stevenli518/CuBoulder_ECEN4610-20_Capstone/readme.md

# Cu-Boulder-ECEN-Capstone-Project-Team808

## Scalable Electrosurgical Unit for Controlling and Powering the Ligasure Dissection Device
Team Member:

- Sonal Tamrakar (Team Lead/PCB Design Specialist)
- Rustin Chang (Hardware Lead)
- Ali Moran (Product Manual Editor)
- Chengming Li (Software Lead)
- Daniel Chun (Financial Manager/Morale Manager)
- Noah Zhao (Communications Manager)

### Project Info:
An electrosurgical device, or ESU, is a surgical incision device used to incise and remove organic tissue efficiently while controlling bleeding. As it currently stands, ESUs are inaccessible to many parts of the world due to their power generator’s steep cost and large size. Our product is a smaller, less expensive ESU, a complete system with a generator, which runs off of an AC wall connection along with batteries. A portable, relatively cheap generator that connects to pre-existing Ligasure devices reliably provides the electrical signals and control functions required by the ESUs, which along with a clear guided user interface makes this ESU system accessible to medical fields in developing countries.
