stevenli518/CuBoulder_ECEN4610-20_Capstone/Semester 2/Week 1/Volt. Sense Calculations.docx

3.3/288=0.01145833333

(288 V)/(0.01 A)=28800 Ω

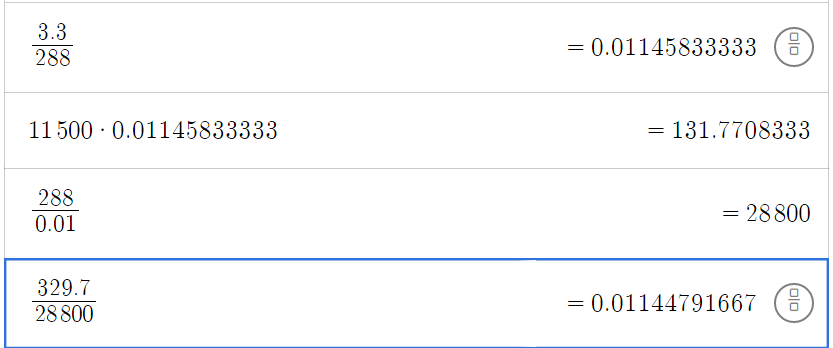
[picture p1: figure]

X_c (reactance)=1/(2πfC)

330=1/(2πfC)=>C_1 (bottom cap->output)=1.08869*10^(-9) F

28470=1/(2πfC)=>C_2 (top cap)=1.26191*10^(-11) F

v_1 =v_(in) (C_2)/(C_1 +C_2)

v_2 =v_(in) (C_1)/(C_1 +C_2)

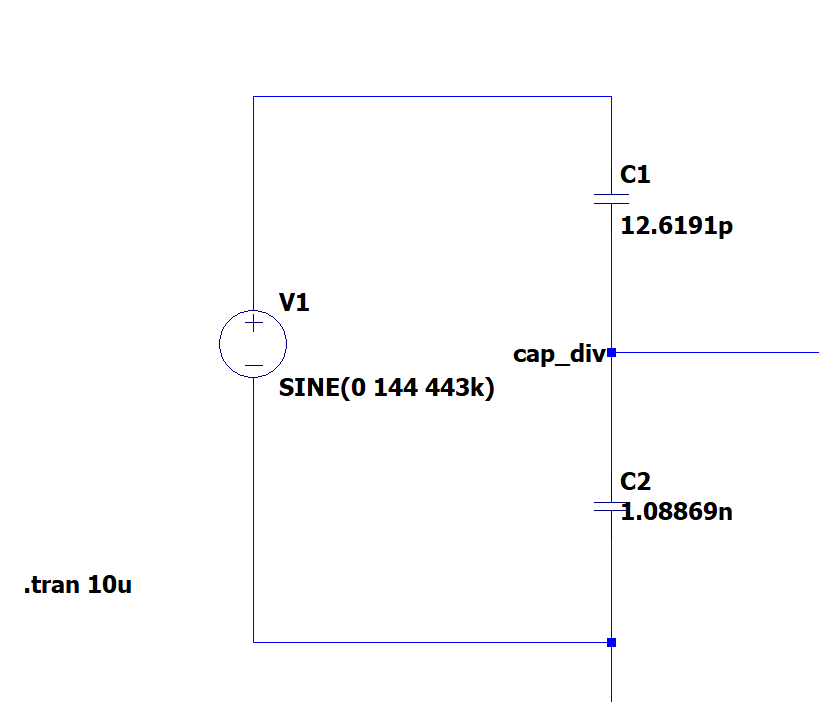
[picture p2: figure]
