stevenli518/CuBoulder_ECEN4610-20_Capstone/Semester 2/Week 10/TA_CHECK_IN_03_23_2023.pptx

## Team 808 Scalable ESU

TA Check-In: 03/23/2023

## Sonal Tamrakar

- What I planned to accomplish in the last 2 weeks
  - Finish Integration Test #3
  - Start working on getting the box dimensions and box ordered
  - Mount heatsinks and insert the system on a mount provided by Medtronic
- What I actually accomplished in the last 2 weeks
  - Finished Integration Test #3
  - Resoldered processors on the shorted controller board (3.3VDig to GND shorted)
  - Installed new FETs (100V rated) + heat sink
- What I expect to accomplish in the next 2 weeks
  - Get the box ordered with the appropriate dimensions
  - Finish Product Manual and Acceptance next plan
  - Create BOM for all schematic components.

## Rustin Chang

- What I planned to accomplish in the last 2 weeks
  - Integration test #3
  - Wind Isolation transformer
  - Figuring out layout of system box
- What I actually accomplished in the last 2 weeks
  - Finished integration test #3
  - Winded Isolation transformer
  - Figured out how to layout the systeem box
- What I expect to accomplish in the next 2 weeks
  - Acceptance Test Demo
  - Having box ordered
  - Poster preparation

## Ali Moran

- What I planned to accomplish in the last 2 weeks
  - GUI development
  - Product manual update
  - Implement timing loop
- What I actually accomplished in the last 2 weeks
  - GUI development
  - Prouduct manual update
  - Timing loop
- What I expect to accomplish in the next 2 weeks
  - box stuff
  - finalize gui
  - further testing

## Steven

- What I planned to accomplish in the last 2 weeks
  - Verified the RMS calculations and results
- What I actually accomplished in the last 2 weeks
  - Verified the correctness of of RMS calculations when it’s open circuit
- What I expect to accomplish in the next 2 weeks
  - Find the issue causing incorrect RMS results when it’s connected to the load
  - Finish product manual and acceptance plan

## Noah Zhao

- What I planned to accomplish in the last 2 weeks
  - Final integration test
  - Begin to design enclosure
- What I actually accomplished in the last 2 weeks
  - Final integration test
  - Begin to design enclosure
- What I expect to accomplish in the next 2 weeks
  - Product manual update
  - Acceptance Testing

## Daniel Chun

- What I planned to accomplish in the last 2 weeks
  - RF Tank prototyping
- What I actually accomplished in the last 2 weeks
  - Purchased all components
  - Finished functional RF Tank
- What I expect to accomplish in the next 2 weeks
  - Finish preparations for sensor integration test
  - Continue working with the transfer function of our LCC tank
