stevenli518/CuBoulder_ECEN4610-20_Capstone/Semester 2/Week 12/TA_CHECK_IN_04_06_2023.pptx

## Team 808 Scalable ESU

TA Check-In: 03/23/2023

## Sonal Tamrakar

- What I planned to accomplish in the last 2 weeks
  - Debug the noise measured in the voltage and current sensor opamp
  - Write up a robust acceptance test plan
- What I actually accomplished in the last 2 weeks
  - Added a ferrite bead along with the twisted pair setup connecting back to the ADCs
  - Replaced standard probes with low voltage differential probes to accurately measure voltage + current sensor plots
  - Measured our system with different loads provided by Medtronic (50, 100, 500, 1k, 1.5k)
- What I expect to accomplish in the next 2 weeks
  - Finish the box enclosure for the acceptance test demo
  - Get started on EXPO poster
  - Finalize product enclosure

## Rustin Chang

- What I planned to accomplish in the last 2 weeks
  - Hunt the noise that was appearing with the ADC
  - Wind Isolation transformer
  - product manual update
- What I actually accomplished in the last 2 weeks
  - Fixed the noise with the ADC
  - Winded Isolation transformer
  - Finished product manual update
- What I expect to accomplish in the next 2 weeks
  - Acceptance Test Demo
  - Having box ordered
  - Poster preparation

## Ali Moran

- What I planned to accomplish in the last 2 weeks
  - GUI development
  - get testing board
- What I actually accomplished in the last 2 weeks
  - GUI development
  - product manual update
  - testing board aquired
- What I expect to accomplish in the next 2 weeks
  - poster
  - final preparations for expo
  - understand the magnetics better

## Steven

- What I planned to accomplish in the last 2 weeks
  - Find the issue causing incorrect RMS results when it’s connected to the load
  - Finish product manual and acceptance plan
- What I actually accomplished in the last 2 weeks
  - Find the issue causing incorrect RMS results when it’s connected to the load
  - Finish product manual and acceptance plan
- What I expect to accomplish in the next 2 weeks
  - Invert the collected voltage samples due to the inverting circuit
  - Scale down the current samples because of the sensor resistor
  - Help with the poster

## Noah Zhao

- What I planned to accomplish in the last 2 weeks
  - Spring break
  - Acceptance test plan
  - Product manual update
- What I actually accomplished in the last 2 weeks
  - Spring break
  - Acceptance test plan
  - Product manual update
- What I expect to accomplish in the next 2 weeks
  - Complete system enclosure
  - Acceptance Testing

## Daniel Chun

- What I planned to accomplish in the last 2 weeks
  - Finish product manual design section
- What I actually accomplished in the last 2 weeks
  - Completed all design documentation for product manual
  - Began finalizing power budget
- What I expect to accomplish in the next 2 weeks
  - Finalize all hardware quirks
  - Fabricate the box for our system
  - Begin preparations for expo
