stevenli518/CuBoulder_ECEN4610-20_Capstone/Semester 2/Week 13/TA_CHECK_IN_04_20_2023.pptx

## Team 808 Scalable ESU

TA Check-In: 04/20/2023

## Sonal Tamrakar

- What I planned to accomplish in the last 2 weeks
  - Finish Acceptance Plan
  - Start with poster
- What I actually accomplished in the last 2 weeks
  - FInish Poster
  - Box setup completed
  - Measured our system with bacon/saline gauze
- What I expect to accomplish in the next 2 weeks
  - Get ready for EXPO

## Rustin Chang

- What I planned to accomplish in the last 2 weeks
  - Put some finishing touches on the project (set up in the box and scope probe placements)
  - Work on Expo poster
- What I actually accomplished in the last 2 weeks
  - Finished up the project
  - Finished the expo poster
- What I expect to accomplish in the next 2 weeks
  - Buying more stuff to fry with the bizact
  - Figure out table set up
  - EXPO!!!!!!!

## Ali Moran

- What I planned to accomplish in the last 2 weeks
  - fix float conversion error
  - fix graphing - either horrid and innacurate or freezes the gui
  - homogenize data input from the board
- What I actually accomplished in the last 2 weeks
  - float conversion fixed
  - graph freezing fixed but now not accepting data
  - data input is now clean
- What I expect to accomplish in the next 2 weeks
  - expo
  - pracitce elevator pitch more
  - finalize gui in the next few days - add extensive comments for next people

## Steven

- What I planned to accomplish in the last 2 weeks
  - Invert the voltage samples due to the inverting circuit
  - Scale down the current samples because of the sensor resistor
  - Help with the poster
- What I actually accomplished in the last 2 weeks
  - Invert the voltage samples due to the inverting circuit
  - Scale down the current samples because of the sensor resistor
  - Help with the poster
- What I expect to accomplish in the next 2 weeks
  - Practice the elevator pitch
  - EXPO

## Noah Zhao

- What I planned to accomplish in the last 2 weeks
  - Complete enclosure
  - Acceptance testing
  - Poster
- What I actually accomplished in the last 2 weeks
  - Complete enclosure
  - Acceptance testing
  - Poster
- What I expect to accomplish in the next 2 weeks
  - Expo preparation
  - Learn all system modules in depth
  - Last product manual update

## Daniel Chun

- What I planned to accomplish in the last 2 weeks
  - Finish final touches on hardware
- What I actually accomplished in the last 2 weeks
  - Finished our project for expo
  - Began finalizing preparations for expo
- What I expect to accomplish in the next 2 weeks
  - Continue preparations for expo
  - Finish product manual
