stevenli518/CuBoulder_ECEN4610-20_Capstone/Semester 2/Week 2/TA_Check-in_1_26_2023.pptx

## Team 808 Scalable ESU

TA Check-In 6: 1/26/2023

## Sonal Tamrakar

- What I planned to accomplish in the last 2 weeks
  - Finalize 2nd PCB (final)
  - Test controller board using power supply.
  - Finalize RF Tank + Voltage Sensor calculations
- What I actually accomplished in the last 2 weeks
  - 2nd PCB (final) almost finished
  - Finished testing controller board using power supply instead of soul bay.
  - Design custom footprints for inductors/caps/transformer
- What I expect to accomplish in the next 2 weeks
  - Finish CDR slides
  - Appt with Medtronic advisor regarding CDR
  - Visit Power Lab

## Rustin Chang

- What I planned to accomplish in the last 2 weeks
  - Finish PCB design
  - Simulate RF tank on LTspice making sure the design is concrete before being placed on the board
  - Implement the inverting OP amp topology
- What I actually accomplished in the last 2 weeks
  - Finished the RF tank design
  - Simulated the RF tank successfully
  - Successfully finished the inverting OP amp topology
- What I expect to accomplish in the next 2 weeks
  - Start working on the integrated design test
  - look into winding transformers and inductors
  - Complete some matlab simulations

## Ali Moran

- What I planned to accomplish in the last 2 weeks
  - GUI development
  - Figure out alternatives for sensors
- What I actually accomplished in the last 2 weeks
  - Started GUI
  - Figured out alternatives but were not using
- What I expect to accomplish in the next 2 weeks
  - Integrate serial/excel into GUI
  - Gain a better understanding of graphing in excel
  - Have a working GUI to test custom boards through

## Steven

- What I planned to accomplish in the last 2 weeks
  - Merge CLA and ADC into the project I am working on
  - Setup the RMS value calculation in the CLA’s tasks
  - Do some experiments to prove the RMS value is correct with 8 samples/ cycle
- What I actually accomplished in the last 2 weeks
  - CLA and ADC is merged into the project(but it not working)
  - RMS value calculation done
  - RMS value close to what oscilloscope gives
- What I expect to accomplish in the next 2 weeks
  - Fix the problem about CLA and ADC
  - Prove the correctness of RMS values

## Noah Zhao

- What I planned to accomplish in the last 2 weeks
  - Redesign of voltage/current sensors
  - Answer some questions from previous semester
- What I actually accomplished in the last 2 weeks
  - Help redo sensor circuits
  - Got some questions answered from previous semester
- What I expect to accomplish in the next 2 weeks
  - MATLAB sim for point by point RMS calculation
  - Answer questions from last check in with Bogatin
  - CDR

## Daniel Chun

- What I planned to accomplish in the last 2 weeks
  - Voltage Sensor final design
  - Current Sensor final design
  - LTspice Simulations
- What I actually accomplished in the last 2 weeks
  - Voltage Sensor final design
  - Successful LTspice Simulations
- What I expect to accomplish in the next 2 weeks
  - Finalize exact values for voltage and current sensors
  - Begin integration testing phase of project
  - Prepare for the CDR
