stevenli518/CuBoulder_ECEN4610-20_Capstone/Semester 2/Week 2/Volt. Sense FINAL.docx

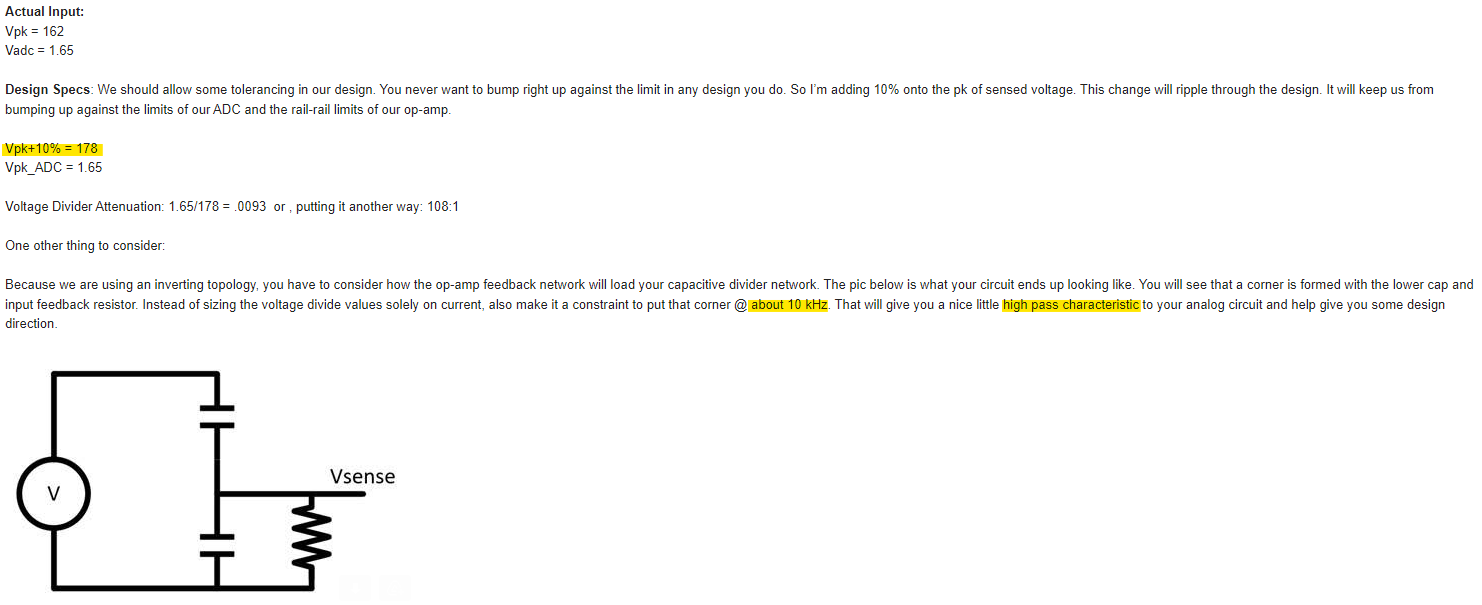
[picture p3: figure]

Parameters

V_(peak) =162V±10%

V_(peak) +Attentuation≈178V

ADC Range: 0V to 3.3V

V_(peak-to-peak) =356V

Calculation of HPF @10kHz

Using 10k Ohm for input feedback resistor

https://www.electronics-tutorials.ws/filter/filter_3.html

10kHz =1/(2π*10k*C_2)=> C_2 =1.59154943*10^(-9) =1.592nF

Solving for C_1

3.3/356=0.009269662921

v_2 =v_(in) (C_1)/(C_1 +C_2) =>3.3=(356)(C_1)/(C_1 + 1.59*10^(-9)) =>C_1 =1.48954*10^(-11) =14.9pF

Calculation of LPF @2.5MHz

R = 10k Ohms

https://www.electronics-tutorials.ws/filter/filter_2.html

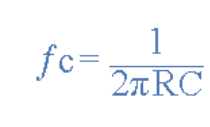
[picture p4: figure]

2.5Meg =1/(2π*10k*C)=>C=6.3662*10^(-12)
