stevenli518/CuBoulder_ECEN4610-20_Capstone/Semester 2/Week 3/Weekly Meeting 1.31.docx

Magnetics:

- Try a few different gauge wires (maybe 26 gauge)
- Experiment with winding first
- https://www.mag-inc.com/Design/Design-Guides/Inductor-Design-with-Magnetics-Ferrite-Cores

CDR:

- Confidence in the project is most important
- Can use current RF tank values but those don’t have to be final. Just need to mention our path
