stevenli518/CuBoulder_ECEN4610-20_Capstone/Semester 2/Week 4 - CDR/CDR notes.docx

RF tank:

- Only have odd harmonics in fourier domain
- Have to put resonance somewhere so put it on 2nd harmonic where there shouldn’t be any energy

Sensing circuits:

- Talk about input/output. Could place in block diagram
- Possibly could run sim. Show bode plot, gain, show it matches calculations
- Corner, gain, bandwidth
- Cap divider to block DC offset caused by asymmetry from AC switching, minimal amount of current flowing into sense node. No DC power loss. Medtronic legacy design decision. Could use resistor. Theoretically no power loss in cap divider

General:

- List design process of any/all sub module
- Show both PCBs instead of eval board in software slides (slide 28)
- Show we are ready for integration testing
- Show transitions of boards and our process/journey
- Describe module functions qualitatively rather than numerically

Overlap of phase gives amplitude control, can leave 48V constant then use phase to control output of square wave
