stevenli518/CuBoulder_ECEN4610-20_Capstone/Semester 2/Week 4 - CDR/Notes_2.8.docx

Primary side of step-up:

- 96V peak-to-peak from h-bridge
- 48V peak

Secondary side of the step-up

- 48V*3 = 144V Peak
- 288V peak-to-peak
- 101.8233765V RMS
