stevenli518/CuBoulder_ECEN4610-20_Capstone/Semester 2/Week 5/RF Tank Capacitors.docx

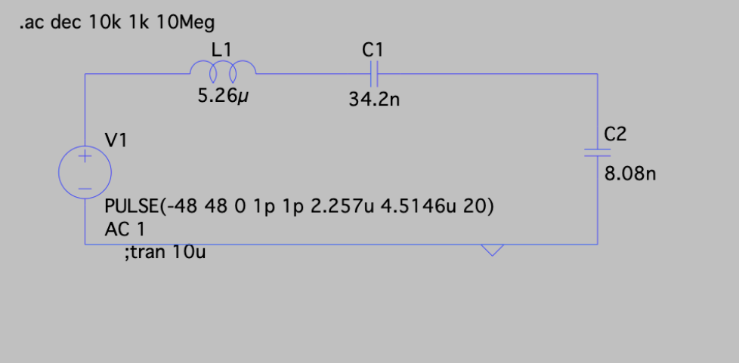
[picture p9: figure]

- C1 has 4 parallel footprints
- C2 has 2 parallel footprints

Current calculations:

- I_(sc) RMS=5A
- d=0.25
- n_(ratio) =2.5

Accounting for 10% variable swing

I_(sc) RMS=5.5A

I_(sc) RMS (Primary) = 5.5*n=> 5.5*2.5=13.75A

Accounter for 25% Duty cycle

I RMS (Primary) 13.75A*0.25=3.4375A

Calculations for C1:

- C_1 (1)=9100pF
- C_1 (2)=9100pF
- C_1 (3)=9100pF
- C_1 (4)=6800pF

https://www.electronics-tutorials.ws/filter/filter_1.html

X_1 (1)=X_1 (2)=X_1 (3)=1/(2π*430000*9100*10^(-12))=40.67338183Ω

X_1 (4)=1/(2π*430000*6800*10^(-12))=54.43055509Ω

https://www.electronics-tutorials.ws/dccircuits/current-divider.html

By current division:

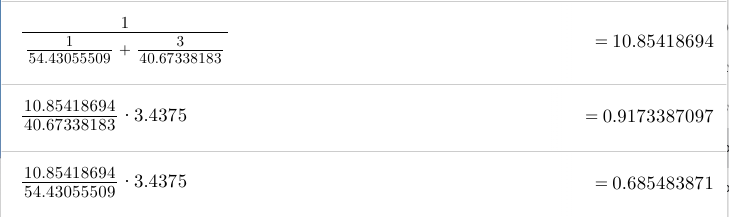
[picture p10: figure]

- 0.9173A through 9100pF capacitors
- 0.6855A through 6800pF capacitors

Calculations for C2:

- C_2 (1)=3900pF
- C_2 (2)=4300pF

(The choice behind the values is to make sure one capacitor isn’t handling a disproportionately large amount of current)

X_2 (1)=1/(2π*430000*3900*10^(-12))=94.9045576Ω

X_2 (2)=1/(2π*430000*4300*10^(-12))=86.07622666Ω

Doing current division

- 1.634908537A through 3900pF
- 1.802591463A through 4300pF
