stevenli518/CuBoulder_ECEN4610-20_Capstone/Semester 2/Week 5/Weekly Meeting 2.14.docx

Transformer:

- Saturation equation

∫_0^(T/2) V_(pk) sin(2πft)dt=(V_(pk))/(πf)

(V_(pk))/(πf)=λ_1 (Volt-seconds)

(V_(pk))/(πf)<n*2ΔB*A_c

Peak Flux Density

B = 200 mT

162 mm^2 = 0.000162 m^2

61V Peak

178V Peak

Inductor:

- Inductance equation

(μ_0 A_C n^2)/(2l_g)

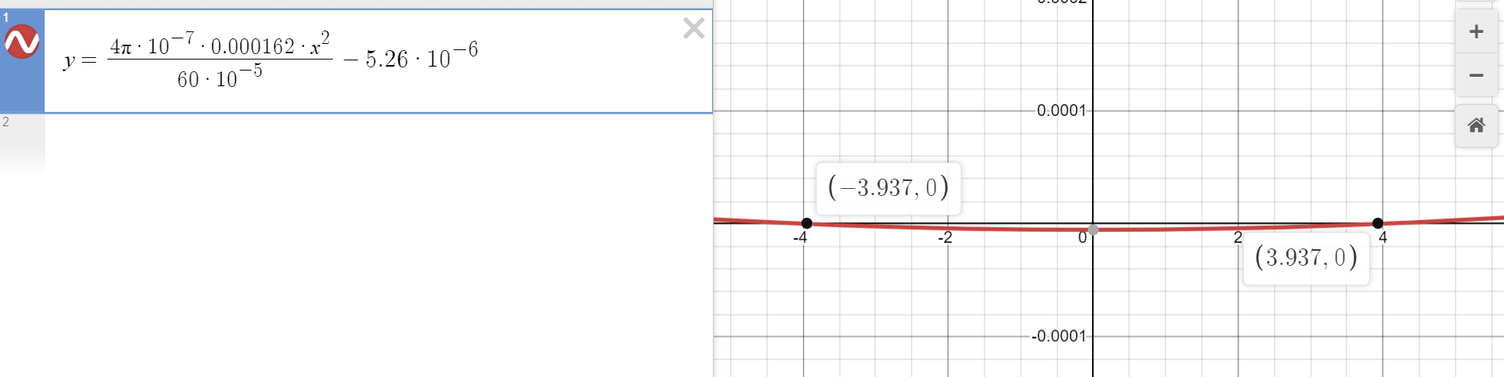
[picture p11: figure]

About 8 pieces of paper

4 turns appromximately

- Saturation equation
