stevenli518/CuBoulder_ECEN4610-20_Capstone/Semester 2/Week 6/Volt_Current Sense 2.19.docx

(178 V)/(0.01 A)=17800 Ω

C_1 =15 pF

X_c (reactance)=1/(2πfC)

X_1 =1/(2π*443000*C_1)=24675.18498 Ω

(178V)/24675.18498=0.00721372505 A = 7.21 mA
