stevenli518/CuBoulder_ECEN4610-20_Capstone/Semester 2/Week 6/Weekly Meeting 2.21.docx

Ask about sense resistor

Ask about heat extrusion (2x, one for top, one for bottom set), should we come to medtronic for that?

Connect the two boards together, HOW? What kind of cables would we run?
