stevenli518/CuBoulder_ECEN4610-20_Capstone/Semester 2/Week 8/TA_Check-in_03_09_2023.pptx

## Team 808 Scalable ESU

TA Check-In: 2/23/2023

## Sonal Tamrakar

- What I planned to accomplish in the last 2 weeks
  - Solder the I/V sensors / Solder sense resistor
  - Install extruded heatsinks on FETs
  - Develop ideas on what to display at the EXPO
- What I actually accomplished in the last 2 weeks
  - Successfully soldered the I/V sensors
  - Finished 2nd Integration Test Demo
- What I expect to accomplish in the next 2 weeks
  - Phoenix connector on 2nd Board
  - Drill GND pads
  - System Integration #3

## Rustin Chang

- What I planned to accomplish in the last 2 weeks
  - Integration test #2
  - have second pcb assembled
  - order parts for the rf tank
- What I actually accomplished in the last 2 weeks
  - Finished integration test #2
  - Finished assembling the second pcb
  - ordered parts for the rf tank
- What I expect to accomplish in the next 2 weeks
  - Integration test #3
  - have mounting set up for system/ fix some of the wiring
  - product manual update/prepare for acceptance test

## Ali Moran

- What I planned to accomplish in the last 2 weeks
  - GUI development
  - Product manual update
- What I actually accomplished in the last 2 weeks
  - GUI development
  - Prouduct manual update
- What I expect to accomplish in the next 2 weeks
  - Implement timing loop
  - Plan control loop for board power, phase sweeping
  - product manual update

## Steven

- What I planned to accomplish in the last 2 weeks
  - Fixed the problem about Synchronization
- What I actually accomplished in the last 2 weeks
  - Fixed the problem about Synchronization
- What I expect to accomplish in the next 2 weeks
  - Implement another method to read the ADC

## Noah Zhao

- What I planned to accomplish in the last 2 weeks
  - Wind magnetics
  - CDR
  - RMS sampling example
- What I actually accomplished in the last 2 weeks
  - Wind magnetics
  - CDR
  - RMS sampling example
- What I expect to accomplish in the next 2 weeks
  - Prepare for integration test 2
  - Product manual revisions

## Daniel Chun

- What I planned to accomplish in the last 2 weeks
  - RF Tank prototyping
- What I actually accomplished in the last 2 weeks
  - Purchased all components
  - Finished functional RF Tank
- What I expect to accomplish in the next 2 weeks
  - Finish preparations for sensor integration test
  - Continue working with the transfer function of our LCC tank
