stevenli518/CuBoulder_ECEN4610-20_Capstone/Semester 2/Week 8/Weekly Meeting 3.7.docx

- The current sensor doesn’t need inversion in code because we are grounding the high side of the sense resistor. Negative(into sensor)>Positive(out of inverting opamp)
- The voltage sensor does need inversion in the code
