stevenli518/CuBoulder_ECEN4610-20_Capstone/Semester 2/EXPO/Elevator Pitch (if you dont memorize, sonal will punish you privately in a dark room).docx

Our project was designing and fabricating an Electrosurgical Unit, which is a generator widely used in the medical industry, that delivers an RF signal to a medical device known as a bizact, used for cauterizing and incising tissue. However, at the moment, many middle and lower income countries are not capable of acquiring ESUs due to their high costs and large size. Therefore, the goal of our project was to create an electrosurgical generator that was not only cost effective but also size efficient as well.
