stevenli518/CuBoulder_ECEN4610-20_Capstone/Semester 2/Week 6/Untitled drawing.jpg

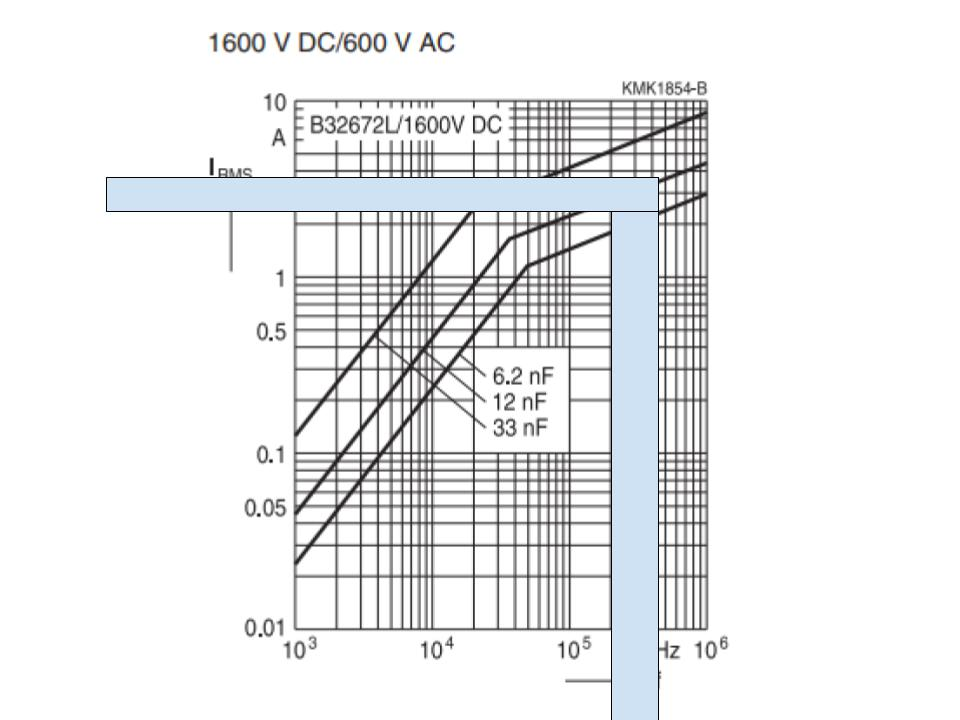
Semester 2/Week 6/Untitled drawing.jpg
