stevenli518/CuBoulder_ECEN4610-20_Capstone/Semester 2/Week 5/Order 2.15_ Sensor Buffer Components 1206.xlsx

Item Name | Capacitance | Voltage Rate | Quantity | Item Link
12062A150JAT2A | 15pF | 200 VDC | 10 | https://www.mouser.com/ProductDetail/KYOCERA-AVX/12062A150JAT2A?qs=EdaiQKp1YqH7cudMOMuIwg%3D%3D
GRM3195C2A162JA01D | 1.6nF (1600 pF) | 100 VDC | 10 | https://www.mouser.com/ProductDetail/Murata-Electronics/GRM3195C2A162JA01D?qs=h0WOCFF19UId94kkiSzFJA%3D%3D
12065A6R2CAT2A | 6.2nF | 50 VDC | 10 | https://www.mouser.com/ProductDetail/KYOCERA-AVX/12065A6R2CAT2A?qs=KpoduxKdAk2yy4TM9rTWqw%3D%3D
 | Resistance | Power Rating
HRG3216P-1002-D-T1 | 10 kOhms | 1W | 20 | https://www.mouser.com/ProductDetail/Susumu/HRG3216P-1002-D-T1
