stevenli518/CuBoulder_ECEN4610-20_Capstone/Semester 2/Week 5/Digi-Key Order 2.9.xlsx

Item name | CPV-PQ35/35-1S-12P-Z | PQ35/35-3F36
Vendor name | Digi-Key | Digi-Key
unit cost | $1.92 | $5.10
number of units requested | 10 | 10
total cost | $19.21 | $50.96
url link | https://www.digikey.com/en/products/detail/ferroxcube/CPV-PQ35-35-1S-12P-Z/7034237 | https://www.digikey.com/en/products/detail/ferroxcube/PQ35-35-3F36/7041668
