stevenli518/CuBoulder_ECEN4610-20_Capstone/Semester 2/Week 6/Digi-Key Order 2.19.xlsx

Item Name | Capacitance | Quantity | Item Link
B32672L1822J000 | 8200 pF | 16 | https://www.digikey.com/en/products/detail/epcos-tdk-electronics/B32672L1822J000/1532433
B32672L1103J000 | 10000 pF | 4 | https://www.digikey.com/en/products/detail/epcos-tdk-electronics/B32672L1103J000/1532434
B32672L8472J000 | 4700 pF | 4 | https://www.digikey.com/en/products/detail/epcos-tdk-electronics/B32672L8472J000/1532447
B32672L8332J000 | 3300 pF | 4 | https://www.digikey.com/en/products/detail/epcos-tdk-electronics/B32672L8332J000/1532444
