stevenli518/CuBoulder_ECEN4610-20_Capstone/Semester 2/Week 6/Digi-key Order 2.21.xlsx

Item | Quantity | Item Link
127698 | 4 | https://www.digikey.com/en/products/detail/wakefield-vette/127698/12090797
60-11-6956-1674 | 25 | https://www.digikey.com/en/products/detail/parker-chomerics/60-11-6956-1674/10456372
