stevenli518/CuBoulder_ECEN4610-20_Capstone/Semester 2/Week 10/Acceptance Test Plan.xlsx

System Power Output
Use case description: |  | Our system must output 50W +- 10% of power across a 100 Ohm resistive load so that we know it can properly cauterize tissue |  |  |  |  | Test ID #: | 1
Description of the test: |  | For this test, we will have our complete generator connected to a 100 ohm resistor as well as a laptop for viewing RMS values. We will have scope probes attached to the output of our system so that we can measure and display voltage to compare to our expected output. Using a 100 Ohm resistor, our system will output 50W +- 10% which meets our 3rd marketing requirements. The rest of our marketing requirements will also be covered in this test as our first requirement is size, which can just be looked at. Our 2nd marketing requirement which is our system outputting 324-334 V peak-to-peak. Finally, our 4th marketing requirement will be met by showing our GUI displaying RMS values |  |  |  |  | Type: | White-Box
Name of Tester: |  | 808 |  |  |  |  | Date:
Hardware Ver: |  | Final |  |  |  |  | Time:
Setup: |  | Our final generator will be connected to a 100 Ohm load as well as a host computer so that PWMs can be generated and rms values can be extracted. Scope probes will be attached across the isolation transformer to measure system outputs.
Step | Action | Expected Output | Pass | Fail | N/A | Comments
1 | Power system to 48 V | 240 +-10% V peak-to-peak sinusoid across output of isolation transformer
2 | Connect 100 ohm load to system output | 50W power across load
3 | Connect system to laptop | Display RMS values to user to ensure system operates properly
4 | Turn PWMs on and gather V_rms and I_rms | Obtain graphs of voltage and current samples for 10 cycles (80 points)
5 | Measuring load impedance | V_rms / I_rms = 100 ohms +- 10%
Overall Test Result:
So-What? |  |  | This test is important as it shows that our product meets all the marketing requirements we defined in our product manual and that our sponsor will accept our design.
