stevenli518/CuBoulder_ECEN4610-20_Capstone/Semester 2/Week 3/Integration Test Plans 808.xlsx

Test Writer: Noah Zhao
Test Case Name: |  | Integration Test: RMS Calculation + GUI operation |  |  |  |  | Test ID #: | 1
Description: |  | 1. What engineering requirement(s) will this test? Our system will correctly calculate AC RMS voltage and current value that our system is outputting. And a point-by-point Power value will be calculated as well.Our GUI will then output that measurement in snapshots at the user's request so that the system behavior can be monitored. 2. Briefly describe what hardware/software elements of your product you will be testing. We will be testing our CLA as well as our GUI using the AD2 and our prototype PCB. 3. Briefly describe what exactly you will be doing in the test. We will use the AD2 wavegen to generate a 0-3.3V 430 kHz sine wave that is inputted to our microcontroller's ADC. Then we will run our CLA to perform the RMS calculation and have the GUI output what the CLA calculated. 4. What is measured and what is the criterion for success? A 0-3.3V 430 kHz sine wave will be sampled at 8 samples per cycle over 1 cycles to calculate an RMS value. If the calculated RMS value displayed on the GUI is the same as what we expect it to be, the test will have been successful. 5. What do you expect as the output of this test? So what? (rule #9) We expect to see a value of 1.16 for the RMS value as this is the RMS value of the test wave we are inputting. |  |  |  |  | Type: | Partial integration level
Tester Information
Name of Tester: |  | Chengming Li |  |  |  |  | Date: | 2023-02-16
Hardware Ver: |  | Board Version 2 |  |  |  |  | Time: | 10:30:00
Setup: |  | How will you set up your test?- what instruments, what measurements? (1) - AD2 is the signal source connected to onboard ADCINA3 and ADCINC2. - W1 and W2 of AD2 will generate two signals with 430 kHz, 1.65 Vamp, 1.65 Voffset. - Voltage, Current, and Power AC RMS will be displayed on the GUI or the Putty Serial Port. What are your "test vectors?" the inputs, and the expected outcomes? (2) - INPUT: Two 430 kHz , 0-3.3V Vpp Sin waves are generated from the AD2 - OUTCOME: 1.16V +- 10% V RMS values Are there any special conditions for your DUT before the test? (3) - N/A What are the software elements included in the test? (4) - Custom GUI or Putty or Code Composer Studio
Test | Input parameter/Action | Expected Output | Pass | Fail | N/A | Actual Output
1 | 430 kHz 3.3Vpp Sin Wave is connected to ADCINA3 | 1.16V AC RMS |  |  |  | 1.16V +- 10% V RMS
2
3
4
5
Overall Test Result:
Test Writer: Rustin Chang
Test Case Name: |  | Integration Test: Resonant Tank |  |  |  |  | Test ID #: | 2
Description: |  | 1. What engineering requirement(s) will this test? The engineering requirement that this test will accomplish is filtering the non-fundamental harmonics of the input square wave that will then produce a sinusoidal signal which then will be used to measure the voltage, current, and power via an ADC on the microcontroller. 2. Briefly describe what hardware/software elements of your product you will be testing. This test will not include any software, though the hardware element that we are testing is the ability to produce a sinusoidal wave which will then be used to measure voltage, current, and power. 3. Briefly describe what exactly you will be doing in the test. Using the keysight oscilloscope we will measure the output of the resonant tank and ensure we can produce a sinusoidal wave from the output of the full bridge (squarewave). The max voltage and peak-to-peak voltage will be measured for values of a 48-volt max voltage and a 96-volt peak-to-peak which should reflect the output values of the full bridge. 4. What is measured and what is the criterion for success? The sin wave must be produced and the non-fundamental harmonics are filtered out and the max and peak-to-peak voltage reflect that of the input square wave to indicate success. 5. What do you expect as the output of this test? So what? (rule #9) We expect a 48-volt max voltage, 96-volt peak to peak voltage sin wave from the output, If this is achieved then we have successfully implemented a resonant tank that 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 |  |  |  |  | Type: | Partial Integration Testing
Tester Information
Name of Tester: |  | Rustin Chang |  |  |  |  | Date: | 2023-03-02
Hardware Ver: |  | Board Version 2 |  |  |  |  | Time: | 11:30:00
Setup: |  | How will you set up your test?- what instruments, what measurements? (1) - Keysight Osciliscope will test resonant tank, which will be probed to the output of the tank itself on the board. - Maximum voltage will be measured by O-scope: peak-to-peak voltage of the sinusoidal wave that will be present at the output - This sinusoidal wave should measure a max voltage of 48 volts and peak-to-peak of 96 volts. - Input voltage provided by external 48V power supply What are your "test vectors?" the inputs, and the expected outcomes? (2) - INPUT: Voltage of 48 volts will be fed through the full bridge Full brifge produces a 96-volt peak-to-peak square wave to be fed into the resonant tank - OUTCOME: 48-volt, 96-volt peak-to-peak sinusoidal wave from the resonant tank Are there any special conditions for your DUT before the test? (3) - N/A What are the software elements included in the test? (4) - There are no software elements included in this test
Test | Input parameter/Action | Expected Output | Pass | Fail | N/A | Actual Output
1 | Supply 48 volt peak square wave | 48 volt peak square wave
2 | Supply 96 volt peak to peak square wave | 96 volt peak to peak square wave
3 | Test probe on output of resonant tank | 48 volt peak sine wave, 96 volt peak to peak sine wave
Overall Test Result:
Test Writer: Sonal Tamrakar
Test Case Name: |  | Integration Test: Full system integration |  |  |  |  | Test ID #: | 3
Description: |  | 1. What engineering requirement(s) will this test? The system integration test will demonstrate the full functionality of the system. 2. Briefly describe what hardware/software elements of your product you will be testing. The hardware includes the two custom built PCBs and the software interface comes from Code Composer Studio which will be used to send the PWM signals as well as do the ADC measurements. 3. Briefly describe what exactly you will be doing in the test. We will setup the system such that the two custom boards are connected together and the all of the individual subsystems are working together. There are testpoints placed on both boards which will measure the four PWM signals, output of the phase-shifted full bridge, output of the RF Tank, output of the 1:3 transformer, and the output from the 1:1 isolation transformer. 4. What is measured and what is the criterion for success? To be successful, our system must run together smoothly, producing the signals and values that match our given project requirements. 5. What do you expect as the output of this test? So what? (rule #9) The expected output will be a 115 V RMS output 430 kHz sine wave.There will be voltage and current sensors on the second PCB that will feed into the ADC pins of our microcontroller. The ADC pins will be used to measure voltage and current. The load on the output will vary, from 10-2k ohms, for which chassis mount resistors will be used. |  |  |  |  | Type: | Final integration level
Tester Information
Name of Tester: |  | 808 |  |  |  |  | Date: | 2023-03-16
Hardware Ver: |  | Board Version 1 + Board Version 2 |  |  |  |  | Time: | 10:30:00
Setup: |  | How will you set up your test?- what instruments, what measurements? (1) - Multiple oscilloscopes will be set up for measurements - Probes will be placed on the 4 PWM signals, the output of the phase shifted full bridge, the output of the RF tank, the output of the 1:3 transformer, and the output of the 1:1 isolation transformer. - Input volatge provided by external 48V power supply - Microcontroller will be connected via UART to host computer with GUI loaded What are your "test vectors?" the inputs, and the expected outcomes? (2) - INPUT: 48 V from external power supply into full bridge - OUTCOME: Full bridge: 430 kHz square wave, RF Tank: 430 kHz sine wave, RMS Voltage: 115 V Are there any special conditions for your DUT before the test? (3) - N/A What are the software elements included in the test? (4) - Custom GUI will display calculated RMS - Microcontroller will have code loaded through code composer studio
Test | Input parameter/Action | Expected Output | Pass | Fail | N/A | Actual Output
1 | Supply 48 volt peak square wave | 48 volt peak square wave
2 | Test probe on output of resonant tank | 48 volt peak sine wave, 96 volt peak to peak sine wave
3 | Test probe on output of 1:3 transformer | 144V peak sine wave
4 | IV Sensors into ADC pins | 0-3.3V scaled down voltage/current in software implemented
5
Overall Test Result:
