stevenli518/CuBoulder_ECEN4610-20_Capstone/Semester 2/Week 3/Test Plan 2 (RF tank).xlsx

Test Writer: Rustin Chang
Test Case Name: |  | Integration Test: Resonant Tank |  |  |  |  | Test ID #: | 2
Description: |  | 1. What engineering requirement(s) will this test? The engineering requirement that this test will accomplish is filtering the non-fundamental harmonics of the input square wave from the full bridge (Cphase of 120 degrees) that will then produce a sinusoidal signal of 430kHz 2. Briefly describe what hardware/software elements of your product you will be testing. This test will not include any software, though the hardware element that we are testing is the ability to produce a sinusoidal wave. 3. Briefly describe what exactly you will be doing in the test. Using the keysight oscilloscope we will measure the output of the resonant tank and ensure we can produce a sinusoidal wave from the output of the full bridge (squarewave). For this test, we do not currently have the heat sinks for our full bridge MOSFETs, therefore, we will be inputting a lower peak voltage into the full bridge (12V, 24V peak-to-peak). Based on the FS of our pseudo-square wave and the total gain of our LCC resonant tank, we should expect our fundamental harmonic amplitude to be around 14.32V peak and 28.64V peak-to-peak. 4. What is measured and what is the criterion for success? We will measure across the output capacitor of our LCC LP filter topology. We expect a sine wave at a Cphase input of 120 degrees with an output voltage that is 14.32V peak and 28.64V peak-to-peak with a 12V input into our full bridge. 5. What do you expect as the output of this test? So what? (rule #9) We expect a sine wave outp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 |  |  |  |  | Type: | Partial integration level
Tester Information
Name of Tester: |  | Rustin Chang |  |  |  |  | Date: | 2023-03-02
Hardware Ver: |  | Board Version 2 |  |  |  |  | Time: | 10:00:00
Setup: |  | How will you set up your test?- what instruments, what measurements? (1) - Keysight Oscilloscope will test the resonant tank, which will probe the output of the tank on our custom PCB. These probes will also acquire the peak-to-peak voltage our output. - Our resonant tank board will be wired to our microprocessor/full bridge board in which we will input a Cphase of 120 degrees through the Putty interface to produce a pseudo square wave from the full bridge. - Input voltage (12V) will be provided by an adjustable DC power supply What are your "test vectors?" the inputs, and the expected outcomes? (2) - INPUT: Voltage of 12V will be fed into the full bridge with a Cphase of 120 degrees Full-bridge will then produce a 24V peak-to-peak square wave which will input into the resonant tank - OUTCOME (output of resonant tank): 28.64V peak-to-peak sinusoidal wave from the resonant tank Are there any special conditions for your DUT before the test? (3) - N/A What are the software elements included in the test? (4) - The Putty interface will be used to toggle the Cphase value to control the MOSFET gate signals PWMs
Test | Input parameter/Action | Expected Output | Pass | Fail | N/A | Actual Output
1 | Supply 12V DC | 24V peak-to-peak pseudo square wave
2 | Input 120 degree Cphase | T_on of approximately 0.78 uS
3 | Input 24V peak-to-peak pseudo square wave | 28.64V peak-to-peak sine wave
Overall Test Result:
