stevenli518/CuBoulder_ECEN4610-20_Capstone/Semester 2/Week 9/Copy of System Test Plan 3.15.xlsx

Test Writer: Sonal Tamrakar
Test Case Name: |  | Integration Test: Full system integration |  |  |  |  | Test ID #: | 3
Description: |  | 1. What engineering requirement(s) will this test? The system integration test will demonstrate the full functionality of the system. We will demonstrate that the RF Tank will properly produce a sine wave with an amplitude corresponding to the input DC signal. Furthermore, we will demonstrate the functionality of the IV sensors which will provide RMS IV measurements. 2. Briefly describe what hardware/software elements of your product you will be testing. The hardware includes the two custom built PCBs and the software interface comes from Code Composer Studio which will be used to send the PWM signals as well as do the ADC measurements. 3. Briefly describe what exactly you will be doing in the test. We will set up the system such that the two custom boards are connected together and the all of the individual subsystems are working together. There are testpoints placed on both boards which will measure the four PWM signals, output of the phase-shifted full bridge, output of the RF Tank, output of the 1:2.5 transformer. From there, our output will be connected to a resistor which will act as our load. 4. What is measured and what is the criterion for success? To be successful, our different subsystems must interact successfully in which they should produce the signals and values that match our given project requirements. 5. What do you expect as the output of this test? So what? (rule #9) The expected output will be a 241 V peak-to-peak 430 kHz sine wave based upon a 48V inpu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 |  |  |  |  | Type: | Final integration level
Tester Information
Name of Tester: |  | 808 |  |  |  |  | Date: | 2023-03-16
Hardware Ver: |  | Board Version 1 + Board Version 2 |  |  |  |  | Time: | 11:30:00
Setup: |  | How will you set up your test?- what instruments, what measurements? (1) - Multiple oscilloscopes will be set up for measurements - Probes will be placed on the 4 PWM signals, the output of the phase shifted full bridge, the output of the RF tank, and the output of the 1:2.5 transformer. Furthermore a current probe will be placed on the connection wire to our load resistor. - Input voltage provided by external 48V (max( power supply - Putty will display RMS values What are your "test vectors?" the inputs, and the expected outcomes? (2) - INPUT: 40 V from external power supply into full bridge - OUTCOME: Full bridge: 430 kHz square wave, RF Tank: 430 kHz sine wave, 240 V peak-to-peak Are there any special conditions for your DUT before the test? (3) - N/A What are the software elements included in the test? (4) - Putty GUI will display calculated RMS - Microcontroller will have code loaded through code composer studio
Test | Input parameter/Action | Expected Output | Pass | Fail | N/A | Actual Output
1 | 40 V DC. 120 Degree CPhase input into Putty | 80 V peak-to-peak square wave (measured using differential probes)
2 | 80 V peak-to-peak square wave (measured using differential probes) | 96 V peak-to-peak sinusoidal wave (measured using differential probes) from RF Tank
3 | 96 V peak-to-peak sinusoidal wave (measured using differential probes) | 241V peak-to peak sinusoidal wave out of the 1:2.5 step-up transformer
4 | IV Sensors into ADC pins | 0-3.3V scaled down voltage/current in software implemented and displayed on scope channels
5 | RMS values displayed on Putty GUI | Matches with calculated RMS based on oscilloscope readings
Overall Test Result:
