stevenli518/CuBoulder_ECEN4610-20_Capstone/Semester 2/Week 2/Volt_Sense_162V+10__1_24.asc

C1: cap; 14.9p
C2: cap; 1.592n
R1: res; 10k
R2: res; 10k
R3: res; 10k
R4: res; 10k
Secondary_Output: voltage; SINE(0 178 430k); AC 1
U1: AD8032
uC_Source: voltage; 3.3
Named nets: 0, Out, cap_div
.tran 10u
;ac dec 10k 1k 10Meg
