stevenli518/CuBoulder_ECEN4610-20_Capstone/code/SCI_test_Steven_4102023/cla_custom.c

/*
 * cla_custom.c
 *
 *  Created on: Dec 1, 2022
 *      Author: LiChe
 */

#include "cla_custom.h"
#include "cla_ex5_adc_just_in_time_shared.h"
#include "CLAmath.h"

// Linker Defined variables
//extern uint32_t S, Cla1ProgLoadStart, Cla1ProgLoadSize;
//extern uint32_t Cla1ConstRunStart, Cla1ConstLoadStart, Cla1ConstLoadSize;
extern uint32_t Cla1ProgRunStart, Cla1ProgLoadStart, Cla1ProgLoadSize;
extern uint32_t Cla1ConstRunStart, Cla1ConstLoadStart, Cla1ConstLoadSize;

void initCLA(void);


//
// CLA Initialization
//
// Description: This function will
// - copy over code and const from flash to CLA program and data ram
//   respectively
// - Initialize the task vectors (MVECTx)
// - setup each task's trigger
// - enable each individual task
// - map program and data spaces to the CLA
// - run any one-time initialization task
// Please note that the CLA can only run code and access data that is in RAM.
// the user must assign constants (tables) to FLASH, and copy them over to
// RAM at run-time. They must be copied to a RAM that lies in the address space
// of the CLA, and prior to giving the CLA control over that space
//
void initCLA(void)
{
    //
    // Copy the program and constants from FLASH to RAM before configuring
    // the CLA
    //
#if defined(_FLASH)
    memcpy((uint32_t *)&Cla1ProgRunStart, (uint32_t *)&Cla1ProgLoadStart,
           (uint32_t)&Cla1ProgLoadSize);
    memcpy((uint32_t *)&Cla1ConstRunStart, (uint32_t *)&Cla1ConstLoadStart,
        (uint32_t)&Cla1ConstLoadSize );
#endif //defined(_FLASH)

    //
    // CLA Program will reside in RAMLS0 and data in RAMLS1, RAMLS2
    //
    MemCfg_setLSRAMMasterSel(MEMCFG_SECT_LS0, MEMCFG_LSRAMMASTER_CPU_CLA1);
    MemCfg_setLSRAMMasterSel(MEMCFG_SECT_LS1, MEMCFG_LSRAMMASTER_CPU_CLA1);
    MemCfg_setLSRAMMasterSel(MEMCFG_SECT_LS2, MEMCFG_LSRAMMASTER_CPU_CLA1);
    MemCfg_setCLAMemType(MEMCFG_SECT_LS0, MEMCFG_CLA_MEM_PROGRAM);
    MemCfg_setCLAMemType(MEMCFG_SECT_LS1, MEMCFG_CLA_MEM_DATA);
    MemCfg_setCLAMemType(MEMCFG_SECT_LS2, MEMCFG_CLA_MEM_DATA);
#if defined(_FLASH)
    //
    // In Flash config, constants are loaded in Flash and then copied to LS3.
    // CLA reads the constants from LS3.
    //
    MemCfg_setCLAMemType(MEMCFG_SECT_LS3, MEMCFG_CLA_MEM_DATA);
    MemCfg_setLSRAMMasterSel(MEMCFG_SECT_LS3, MEMCFG_LSRAMMASTER_CPU_CLA1);
#endif //defined(_FLASH)

//
// Suppressing #770-D conversion from pointer to smaller integer
// The CLA address range is 16 bits so the addresses passed to the MVECT
// registers will be in the lower 64KW address space. Turn the warning
// back on after the MVECTs are assigned addresses
//
#pragma diag_suppress=770

    //
    // Assign the task vectors and set the triggers for task 1, task 2
    // and 8
    //
    CLA_mapTaskVector(CLA1_BASE, CLA_MVECT_1, (uint16_t)&Cla1Task1);
    CLA_mapTaskVector(CLA1_BASE, CLA_MVECT_2, (uint16_t)&Cla1Task2);
    CLA_mapTaskVector(CLA1_BASE, CLA_MVECT_3, (uint16_t)&Cla1Task3);
    CLA_mapTaskVector(CLA1_BASE, CLA_MVECT_8, (uint16_t)&Cla1Task8);
    CLA_setTriggerSource(CLA_TASK_1, CLA_TRIGGER_ADCA1);
    CLA_setTriggerSource(CLA_TASK_2, CLA_TRIGGER_ADCB3);
    CLA_setTriggerSource(CLA_TASK_3, CLA_TRIGGER_SOFTWARE);
    CLA_setTriggerSource(CLA_TASK_8, CLA_TRIGGER_SOFTWARE);

#pragma diag_warning=770

    //
    // Enable Tasks
    //
    CLA_enableTasks(CLA1_BASE, (CLA_TASKFLAG_3 | CLA_TASKFLAG_8));
    //
    // Force task 8, the one time initialization task to initialize
    // the CLA global variables
    //
    CLA_forceTasks(CLA1_BASE, CLA_TASKFLAG_8);

//    Interrupt_register(INT_CLA1_1, cla1Isr1);
//    Interrupt_enable(INT_CLA1_1);
}
