stevenli518/CuBoulder_ECEN4610-20_Capstone/code/SCI_test_Steven_4102023/custom_dac.h

/*
 * custom_dac.h
 *
 *  Created on: Jan 29, 2023
 *      Author: LiChe
 */

#ifndef CUSTOM_DAC_H_
#define CUSTOM_DAC_H_


#include "driverlib.h"
#include "device.h"
void DAC_init();


#endif /* CUSTOM_DAC_H_ */
