stevenli518/CuBoulder_ECEN4610-20_Capstone/code/SCI_test_Steven_4102023/custom_gpio.h

/*
 * custom_gpio.h
 *
 *  Created on: Jan 31, 2023
 *      Author: LiChe
 */

#ifndef CUSTOM_GPIO_H_
#define CUSTOM_GPIO_H_


#include "board.h"


#define myGPIOOutput 17U
void GPIO_init();

#endif /* CUSTOM_GPIO_H_ */
